claudiusmarius/ESP32-THERMOMETRE-A-LEDS-WS2812B-AVEC-ANNONCE-VOCALE-HEURE-DFTA246/PhotoPCB1.jpg

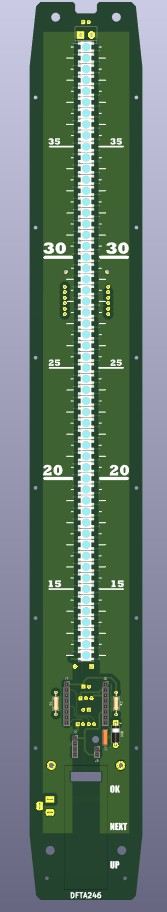
PhotoPCB1.jpg
