claudiusmarius/ESP32-THERMOMETRE-A-LEDS-WS2812B-AVEC-ANNONCE-VOCALE-HEURE-DFTA246/PhotoSHT30.jpg

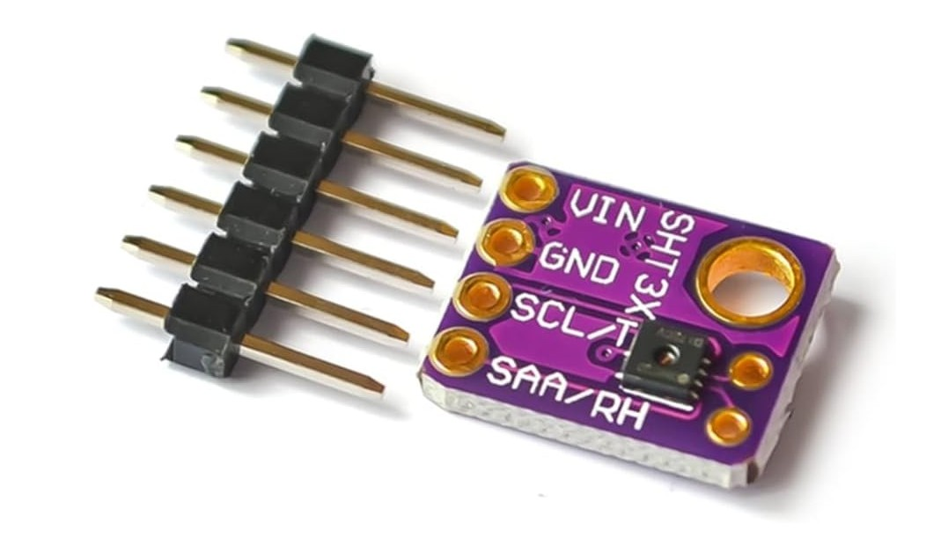
PhotoSHT30.jpg
