claudiusmarius/ESP32-THERMOMETRE-A-LEDS-WS2812B-AVEC-ANNONCE-VOCALE-HEURE-DFTA246/ESP32 C3 écran 0.42.webp

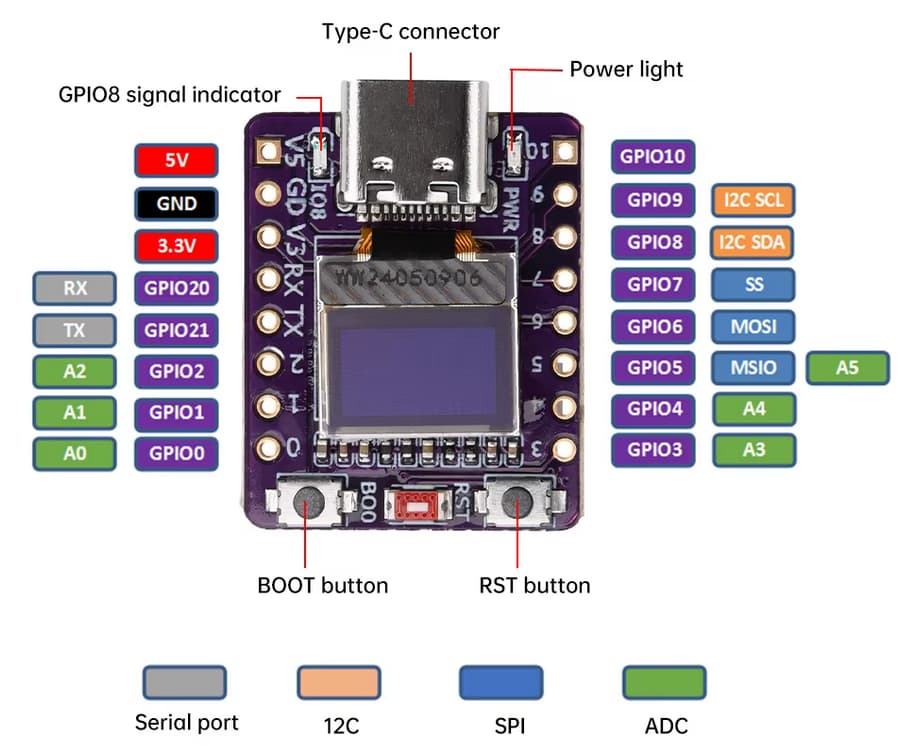
ESP32 C3 écran 0.42.webp
