claudiusmarius/ESP32-THERMOMETRE-A-LEDS-WS2812B-AVEC-ANNONCE-VOCALE-HEURE-DFTA246/PhotoPCB2.jpg

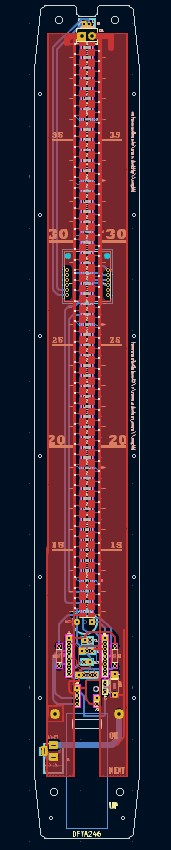
PhotoPCB2.jpg
