claudiusmarius/ESP32-THERMOMETRE-A-LEDS-WS2812B-AVEC-ANNONCE-VOCALE-HEURE-DFTA246/ListeComposantsDFTA246.xlsx

Sheet: Feuil1
REF | VALEUR | UNITE | OBS1 | OBS2
R1 | 220 | Ω | 1/4W
R2 | 10 | KΩ | 1/4W
C1 | 100 | nF | SMD 1206
C2 | 100 | nF | SMD 1206
C3 | 100 | nF | SMD 1206
C4 | 100 | nF | SMD 1206
C5 | 100 | nF | SMD 1206
C6 | 100 | nF | SMD 1206
C7 | 100 | nF | Traversant
D1 à D56 | WS2812B
D58 | 1N5817 |  | Schottky
J1 | Connector_PinSocket_2.54mm:PinSocket_1x08_P2.54mm_Vertical
J2 | Connector_PinSocket_2.54mm:PinSocket_1x08_P2.54mm_Vertical
J3 | Connector_PinSocket_2.54mm:PinSocket_1x02_P2.54mm_Vertical
J4 | Connector_PinSocket_2.54mm:PinSocket_1x02_P2.54mm_Vertical
J5 | Connector_PinSocket_2.54mm:PinSocket_1x02_P2.54mm_Vertical
J6 | Connector_JST:JST_EH_B2B-EH-A_1x02_P2.50mm_Vertical |  | + Limande de connection
J7 | Connector_PinHeader_2.54mm:PinHeader_1x02_P2.54mm_Vertical
J8 | Connector_PinHeader_2.54mm:PinHeader_1x03_P2.54mm_Vertical
J9 | Barrel jack |  | Optionnel
J9 Bis | Embase connecteur jack femelle
J10 | Connector_PinHeader_2.54mm:PinHeader_1x02_P2.54mm_Vertical
J11 | TerminalBlock:TerminalBlock_bornier-2_P5.08mm
J12 | Connector_PinSocket_2.54mm:PinSocket_1x06_P2.54mm_Vertical
J13 | Connector_PinSocket_2.54mm:PinSocket_1x06_P2.54mm_Vertical
Bz1
U1 | DFPlayer PRO |  | Miniplaquette
U2 | ESP32 C3 Oled 0,42' |  | Miniplaquette
U3 | SHT30 |  | Miniplaquette
LDR1 | LDR |  | Optionnel
HP1 | Haut-parleur HP508 |  | 8 Ω - 0,5 W - 50 mm Code : 05518 chez Gotronic
BP1,2,3 | Ensemble de 3 BP plats
 | Cavaliers pour pinheader
 | 4 Petites vis diamètre 4mm
 | 14 petites vis diamètre 1,7mm
PCB | Voir Gerber dans GitHub
 | Adaptateur 5V 3A prise jack |  | Adaptateur MV532N Code : 14667 chez Gotronic

Sheet: Feuil2
1228229 | 7773291
1228230 | 9176626
1228231 | 1228231
 | 1228230
 | 1228229
 | 1446290
 | 7577239
