claudiusmarius/ESP32-THERMOMETRE-A-LEDS-WS2812B-AVEC-ANNONCE-VOCALE-HEURE-DFTA246/DFTA246 Shéma KiCad.pdf

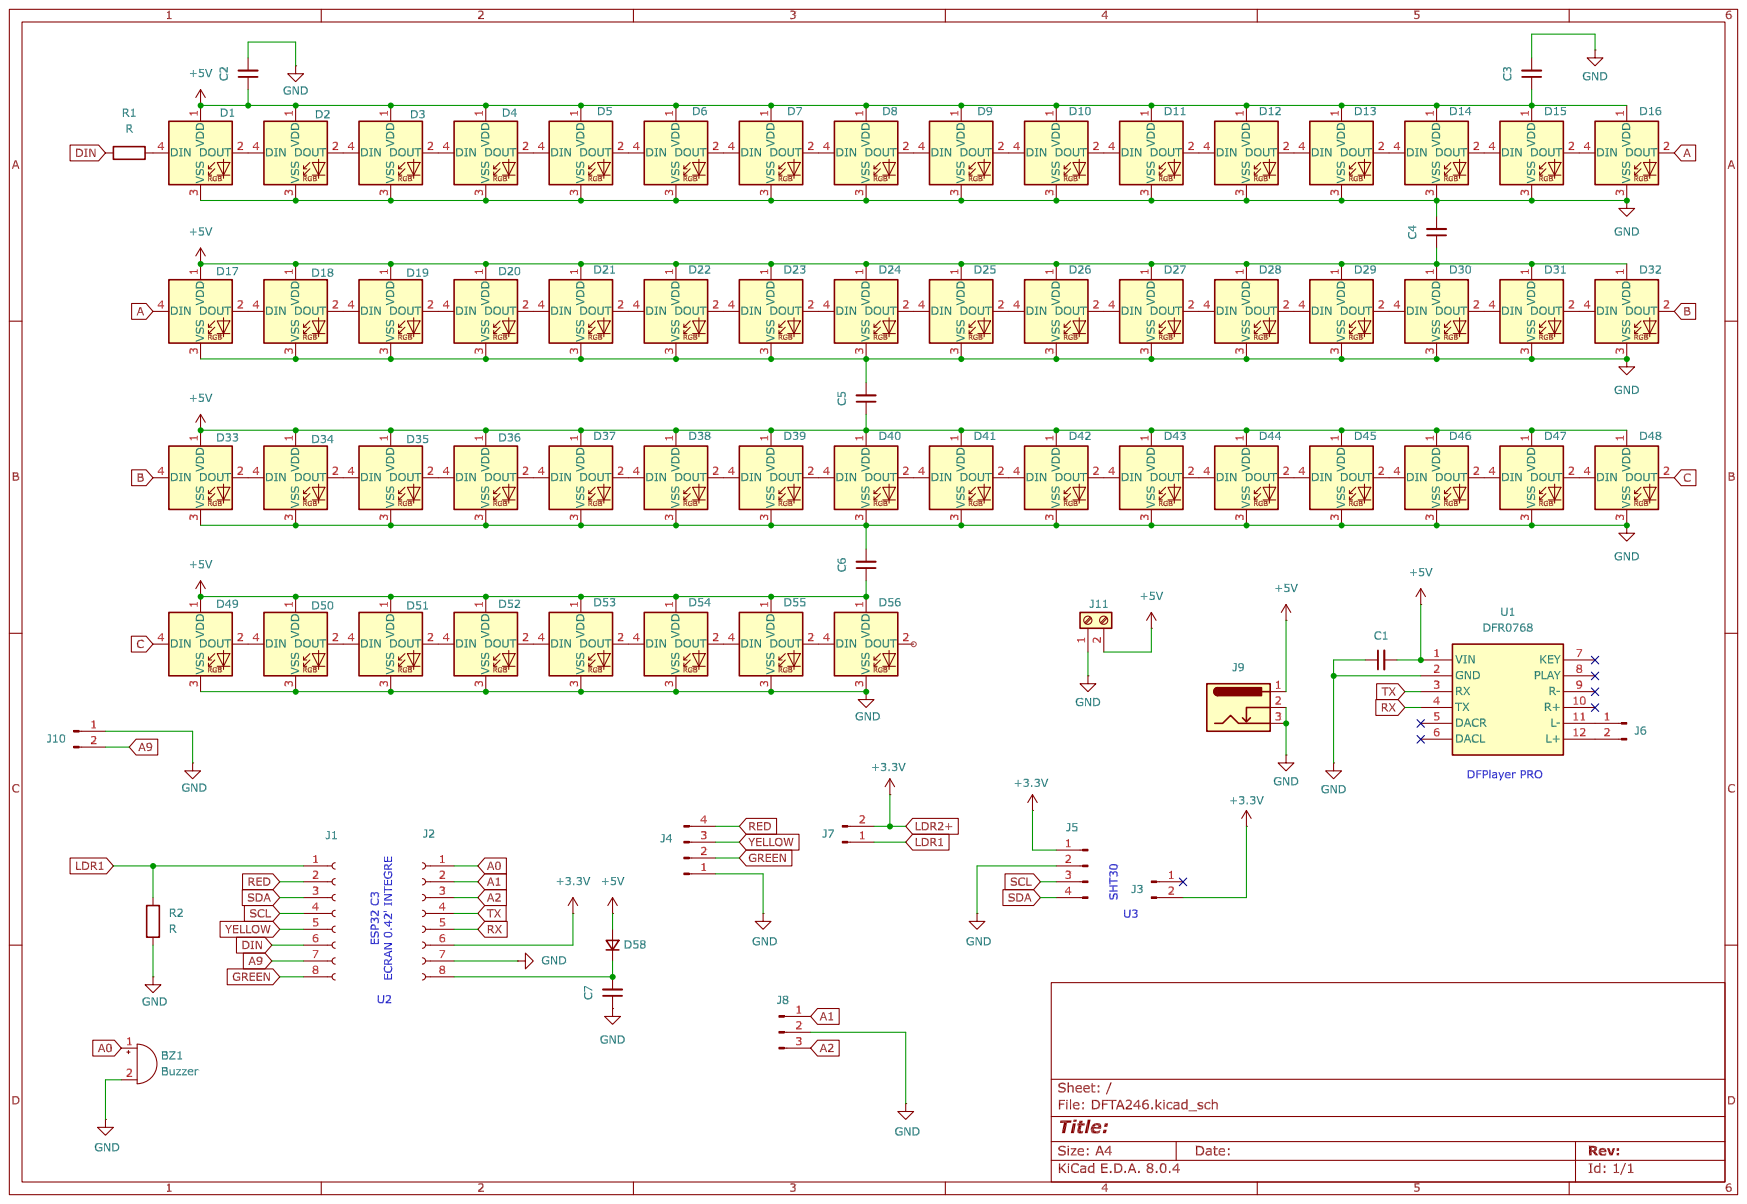
[picture p5: page 1]
