claudiusmarius/ESP32-THERMOMETRE-A-LEDS-WS2812B-AVEC-ANNONCE-VOCALE-HEURE-DFTA246/DFTA246Guide.docx

## Présentation du projet

Ce projet décrit la réalisation d’une navette lumineuse et parlante, basée sur un ESP32-C3, capable d’afficher la température, l’heure, et d’annoncer vocalement l’heure toutes les heures.

GUIDE EN CONSTRUCTION

Cette version V1 se concentre volontairement sur la stabilité, la lisibilité du code et la reproductibilité matérielle.
Les fonctionnalités plus avancées (événements saisonniers, animations complexes) feront l’objet d’évolutions ultérieures.

## 🧾 1. Commander le PCB

Les fichiers de fabrication (Gerber) sont disponibles dans le dépôt.

Le PCB a été conçu pour :

- être simple à assembler
- accepter des variantes (audio / LEDs optionnels)
- rester évolutif

👉 Avant de commander, consultez la nomenclature des composants afin de vérifier les options retenues.

## 📦 2. Nomenclature des composants (BOM)

La nomenclature complète est disponible dans le fichier Excel du GitHub

Elle inclut notamment :

ESP32-C3 avec OLED intégré

Capteur de température SHT30 (I²C)

LEDs adressables WS2812B

DFPlayer Pro (option audio)

Résistances, condensateurs, diode Schottky

Connecteurs pour extensions futures

## 🧱 3. Choix du support

Le PCB a été conçu initialement pour être intégré dans une navette textile, mais il peut être utilisé :

- sur un support rigide
- dans un boîtier imprimé en 3D
- ou en version breadboard pour tests

Une vidéo spécifique sera consacrée aux variantes possibles.

## 🔧 4. Pose des composants

Ordre conseillé :

1. WS2812B
2. Condensateurs cms
3. Composants passifs traversants (résistances, condensateurs)
4. Diode Schottky
5. Connecteurs
6. ESP32-C3
7. SHT30
8. DFPlayer Pro

⚠️ Une attention particulière doit être portée :

- à l’orientation des WS2812B
- à la continuité des rails d’alimentation
- aux masses communes

👉 Une vidéo dédiée expliquera en détail la méthode de soudure des WS2812B.

## 🔌 5. Première mise sous tension

Avant alimentation :

- vérifier l’absence de court-circuit
- vérifier les polarités
- ne pas connecter encore le DFPlayer Pro si optionnel

Alimentation :

- alimentation externe 5V ATTENTION AUX POLARITES
- ou USB (avec protection par diode)

## 📶 6. Entrée des identifiants WiFi

Au premier démarrage :

- Un appui long permet d’entrer en mode configuration
- l’OLED guide l’utilisateur caractère par caractère
- Trois boutons suffisent (UP / NEXT / OK)

Aucun PC, aucune application, aucun smartphone n’est requis.

Les identifiants sont ensuite sauvegardés en mémoire non volatile.

## 🔊 7. Structure des fichiers audio (DFPlayer Pro)

Créer sur le DFPlayer Pro l’arborescence suivante :

/wife/

01.mp3

02.mp3

03.mp3

24.mp3

Ces 24 fichiers correspondent à l’annonce vocale des heures.

👉 La version V1 utilise uniquement ce dossier.
Les versions ultérieures pourront ajouter d’autres dossiers, qui seront simplement ignorés par la V1.

## 👀 8. Observation du comportement

Une fois configurée, la navette :

- affiche alternativement l’heure et la température (et sa tendance)
- anime les LEDs de manière douce
- annonce l’heure vocalement chaque heure

Cette stabilité est la base des évolutions futures.

## 🚀 Et ensuite ?

Les prochaines versions introduiront :

- les événements saisonniers (Noël, Nouvel An)
- des animations lumineuses dédiées
- une architecture audio étendue
- des variantes matérielles

Toujours en conservant la structure et la philosophie de cette V1.
